subu28/airquality/src/screen.h

#include <Adafruit_SSD1306.h>
#include <Wire.h>

#define SCREEN_WIDTH 128 // OLED display width, in pixels
#define SCREEN_HEIGHT 32 // OLED display height, in pixels

Adafruit_SSD1306 display(SCREEN_WIDTH, SCREEN_HEIGHT, &Wire, -1);

void startScreen() {
  if(!display.begin(SSD1306_SWITCHCAPVCC, 0x3C)) { // Address 0x3D for 128x64
    Serial.println(F("SSD1306 allocation failed"));
    for(;;);
  }
}

void show(String text) {
  display.clearDisplay();

  display.setTextSize(1);
  display.setTextColor(WHITE);
  display.setCursor(0, 5);
  // Display static text
  display.println(text);
  display.display(); 
}

void invert(bool inv) {
  display.invertDisplay(inv);
}
