subu28/airquality/(commit log)

2024-05-15 add readme and some screen burn in mitigation
    [airquality.ino, screen.h]
2024-05-15 add case design
2024-05-16 add case stl files
